StationofCommons/MeshRadio/README.md

# MeshRadio

```
   ,___,       /\_/\       __        \|/ \|/      ><{{{(o>
   (O,O)      ( o.o )    <(o )___     \\ //
   /)__)       > ^ <       ( ._> /    (o.o)
   -"-"-                    `---'      \_/
  station 1   station 2   station 3  station 4   station 5
```

A relay station for the Station of Commons installation at ZKM. Each station is a Raspberry Pi 5 with a microphone, a speaker and a button. A visitor holds the button and speaks. The voice travels around a ring of stations over a Wi-Fi mesh, arriving at each one a little later and a little more distorted than at the last.

The same module is built five times for the pilot. Every station runs the same software, and only a short config file differs.

> **Status:** early development. Audio streaming between two Pis and the batman-adv mesh on two Pis were tested on the bench (see [`docs/test-log.md`](docs/test-log.md)). Wiring is in [`docs/wiring.md`](docs/wiring.md), part notes in [`docs/hardware-notes.md`](docs/hardware-notes.md) and bench scripts in [`tools/`](tools/). The ring relay, the button and the systemd services are written but not tested yet, and they are marked as such below.

## Two rules of the piece

1. **Nothing is recorded.** A station only relays a live stream. No audio is written to disk.
2. **The microphone opens on purpose.** It is live only while the button is held. The work never picks up surrounding sound without consent.

## How it works

```
 station 1 --> station 2 --> station 3 --> station 4 --> station 5
     ^                                                       |
     +-------------------------------------------------------+
```

- Every station can take a voice in and relays whatever arrives from the previous station.
- Each station sends to one fixed next station. The ring order is a curatorial choice made once at install time. The stations do not negotiate it.
- The audio is raw 48 kHz PCM sent as RTP over UDP. It is not compressed, so the delay at each station stays predictable.
- Delay comes from `rtpjitterbuffer`, with a floor of 150 ms per station. Real Wi-Fi jitter from distance and crowds adds to it. Dropped packets are meant to be heard as glitches and are not smoothed over.
- Each hop lowers the volume of the relayed signal (about 0.85), so a voice fades after a few trips round the ring.
- The stations find each other with **batman-adv**, a layer 2 mesh. There is no router and no internet. batman-adv only moves packets. It does not decide which station's audio goes where.

## How the mesh works

No Pi hosts the network and no Pi connects to a "closest" Pi. All the stations use the same Wi-Fi network name and channel in ad-hoc (IBSS) mode, so they join one shared network. There is no router and no access point.

- **Every station sends, receives and relays.** Any station within radio range hears the others directly.
- **No station owns the network.** If the first one to start is switched off, the others carry on.
- **batman-adv chooses the route.** For each destination it picks the best neighbour to hand a packet to, based on how many of that node's broadcasts arrive through each one. If a link gets weak, it moves traffic to another route.
- **Stations are identified by MAC address.** batman-adv works below IP, on the MAC of each station's Wi-Fi interface. The IPs on `bat0` (10.0.0.1 to 10.0.0.5) are only there so GStreamer has an address to send to.
- **GStreamer doesn't know about the mesh.** Station 1 sends to station 2's IP. If station 2 is in range, the audio goes straight there. If not, batman-adv carries it through another station.

```
  Station 1 --- Station 2 --- Station 3     Station 1 to 3 goes through
      \                          /          station 2 if they can't hear
       \---- Station 4 ---------/           each other directly
```

A cluster of stations that all hear each other produces a lot of overlapping radio traffic. A spread-out chain has fewer direct links and more hops, which adds delay and jitter.

## Hardware (per station)

| Part | Notes |
|---|---|
| Raspberry Pi 5 (or 4) | Pi 5 has no analog audio jack, so it needs a USB audio device or a HAT |
| Audio in and out | One of the options below |
| Wi-Fi | The onboard Wi-Fi of the Pi 5 joined the batman-adv mesh in ad-hoc mode in our two-Pi test (see `docs/test-log.md`). Range has not been tested. A USB dongle with an Atheros AR9271 chipset (Olimex MOD-WIFI-AR9271) is the fallback if range is poor. Avoid TP-Link TL-WN722N unless it is v1 |
| Push button | Momentary, normally open |
| Directional speaker and amp | To be decided |
| microSD card and USB-C power supply | |

### Audio options

| Option | Input | Output | Pi 5 | Notes |
|---|---|---|---|---|
| Creative Sound Blaster Play! 3 (USB) | 3.5 mm mono mic | two 3.5 mm | untested | About CHF 18. Check the mic level and noise |
| Audient EVO 4 (USB) | XLR or TRS combo | headphone and monitor | untested | Class-compliant. Expensive for five stations |
| UGREEN USB audio adapter | 3.5 mm | 3.5 mm | forum reports say yes | Plug and play |

### Button

Wire the button between a GPIO pin and ground. No resistor is needed, because the internal pull-up is enabled in software. Use `gpiozero`, not `RPi.GPIO`, which does not work correctly on Pi 5.

## Install

On a Raspberry Pi 4 or 5 running Raspberry Pi OS Trixie:

```bash
git clone https://github.com/StationofCommons/MeshRadio.git
cd MeshRadio
./install.sh
```

The installer detects the Pi model, asks for the station number (1 to 5), then installs the packages, the scripts in `scripts/`, the systemd units in `systemd/` and the station config. Options: `--station N`, `--yes`, `--enable-services` (mesh, relay and button at boot), `--force` (other models) and `--dry-run`.

Starting the mesh at boot takes the Wi-Fi away from normal use, so keep Ethernet or a console connected while you work on a station.

Status of the installed pieces: the packages, config and mesh script were tested on a Pi 5. The relay and button services have not been run on a ring yet. The installer itself has only been run in `--dry-run` mode.

## Manual setup

### 1. Install GStreamer

```bash
sudo apt install gstreamer1.0-tools gstreamer1.0-plugins-base \
  gstreamer1.0-plugins-good gstreamer1.0-plugins-bad gstreamer1.0-alsa
```

### 2. Test the audio hardware

List capture devices, then playback devices:

```bash
arecord -l
aplay -l
```

Note the card and device numbers. They are used below as `plughw:CARD,DEVICE`.

Test files:

- Short audio file: https://soccloud.dy.fi/index.php/s/gQj2REPx6Q9sEzF
- Long audio file: https://soccloud.dy.fi/index.php/s/TSWTHZkarkekGKy

### 3. Stream audio between two Pis (tested)

Send a file as MP3 over MPEG-TS. This is a quick bench test only. MP3 adds delay and is not used in the final design.

```bash
gst-launch-1.0 filesrc location=dj.mp3 ! decodebin ! audioconvert ! audioresample \
  ! audio/x-raw,rate=48000 ! lamemp3enc target=bitrate bitrate=128 cbr=true \
  ! mpegaudioparse ! mpegtsmux ! udpsink host=192.168.1.27 port=5000
```

Send from the audio input instead:

```bash
gst-launch-1.0 alsasrc device=plughw:1,0 ! decodebin ! audioconvert ! audioresample \
  ! audio/x-raw,rate=48000 ! lamemp3enc target=bitrate bitrate=128 cbr=true \
  ! mpegaudioparse ! mpegtsmux ! udpsink host=192.168.1.27 port=5000
```

Receive in VLC with `udp://@:5000`.

### 4. Raw RTP pipeline (draft, untested)

Send the microphone to the next station:

```bash
gst-launch-1.0 alsasrc device=plughw:1,0 ! audioconvert ! audioresample \
  ! audio/x-raw,format=S16BE,rate=48000,channels=1 ! rtpL16pay \
  ! udpsink host=NEXT_HOP_IP port=5000
```

Receive, play locally and forward at lower volume:

```bash
gst-launch-1.0 udpsrc port=5000 \
  caps="application/x-rtp,media=audio,clock-rate=48000,encoding-name=L16,channels=1,payload=96" \
  ! rtpjitterbuffer latency=150 drop-on-latency=false do-lost=true \
  ! rtpL16depay ! audioconvert ! tee name=t \
  t. ! queue ! audioresample ! alsasink device=plughw:2,0 \
  t. ! queue ! volume volume=0.85 ! audioconvert \
  ! audio/x-raw,format=S16BE,rate=48000,channels=1 ! rtpL16pay \
  ! udpsink host=NEXT_HOP_IP port=5000
```

Not done yet: an `audiomixer` that combines the local microphone with the incoming relay, so one station can both speak and relay.

## Mesh network (tested on two Pis)

batman-adv runs on the onboard Wi-Fi in ad-hoc (IBSS) mode, with a fixed IP on `bat0` for each station (10.0.0.1 to 10.0.0.5). We use the default routing algorithm, **BATMAN_IV**. BATMAN_V is available in the kernel and has not been tried.

Bring it up by hand with `sudo meshradio-mesh-up up`, and undo it with `sudo meshradio-mesh-up down`. `install.sh` can also start it at boot. Results of the two-Pi test are in [`docs/test-log.md`](docs/test-log.md). Three or more stations, range and the two-way mic are not tested yet.

## Configuration

`install.sh` writes `/etc/meshradio/station.conf`. Only the station number and the addresses derived from it differ between stations:

```
STATION_ID=1
MESH_IP=10.0.0.1
NEXT_HOP_IP=10.0.0.2
```

The file also holds the mesh name and channel, the audio devices (detected, USB preferred), the jitter buffer, the per-hop volume and the button pin.

Station 5 points back to station 1. Run `install.sh` on each Pi with its own number.

## To do

- [ ] Choose the audio hardware (EVO 4 works on a Pi 5; cheaper options untested)
- [x] batman-adv mesh on two Pis
- [ ] batman-adv mesh on three Pis, then five, with range tests
- [ ] Raw RTP pipeline with `audiomixer` and per-hop volume
- [ ] Button script with `gpiozero`: hold to talk, with the pipeline running only while held
- [ ] Test the systemd services on a station (written, not run)
- [x] `install.sh` and a config file for cloning stations (dry-run only, not yet run on a station)
- [ ] Calibrate the delay on site at ZKM
- [ ] Choose the directional speaker and amp
