StationofCommons/MeshRadio/case/stl/puck_diffuser.stl

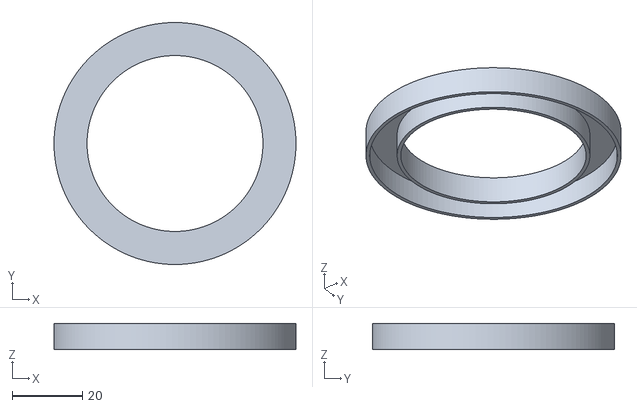
[picture p2: CAD file, 2026-11-03]
case/stl/puck_diffuser.stl
68.8 x 68.8 x 7.50
