StationofCommons/MeshRadio/case/stl/puck_base.stl

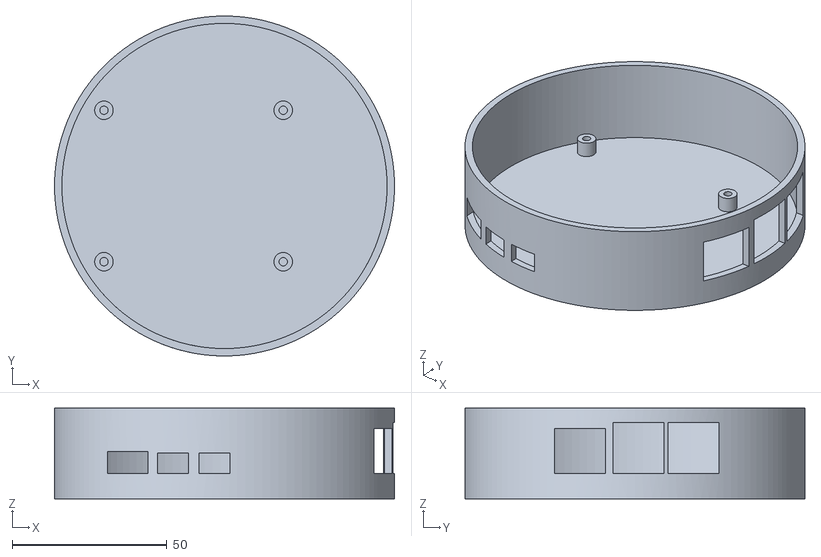
[picture p3: CAD file, 2026-11-03]
case/stl/puck_base.stl
110.0 x 110.0 x 29.4
