StationofCommons/MeshRadio/case/stl/puck_lid.stl

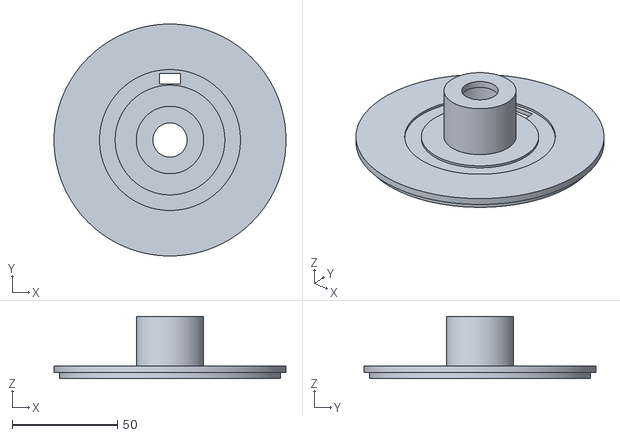
[picture p4: CAD file, 2026-11-03]
case/stl/puck_lid.stl
110.0 x 110.0 x 29.5
