StationofCommons/MeshRadio/(commit log)

2026-10-22 Document bench tests; rebuild install.sh with Pi model detection, mesh and services
    - install.sh detects Pi 4 or 5, asks for the station number, installs packages,
    scripts and systemd units, detects USB audio, writes station.conf
    (flags: --station, --yes, --enable-services, --force, --dry-run)
    - scripts: meshradio-mesh-up (up/down), meshradio-relay, meshradio-button
    - systemd units for mesh, relay and button
    - docs/test-log.md: two-Pi audio and batman-adv results, BATMAN_IV, open items
    - README: install section, mesh tested on onboard Wi-Fi, updated to-do
2026-10-30 install.sh: no HDMI fallback for audio, safer enable prompt, warn that services start the mesh
    - Without a USB sound card, AUDIO_IN and AUDIO_OUT are 'default' instead of card 0 (HDMI on a Pi 5)
    - Enable-at-boot prompt no longer relies on a bare && under set -e
    - Final message warns that starting the relay or button also starts the mesh
2026-10-30 Add wiring and hardware notes, bench tools and the button/ring/song demo
2026-11-03 Add the 3D printed case: CadQuery script, STL files and notes
    [puck_base.stl, puck_diffuser.stl, puck_lid.stl]
